RyuhungLiu/USB-PD-48V-ORing/MainCtrl/docs/ui_palette.png

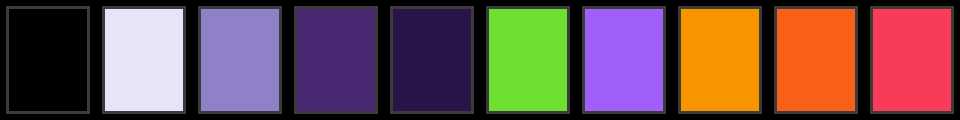
MainCtrl/docs/ui_palette.png
