RyuhungLiu/USB-PD-48V-ORing/MainCtrl/docs/ui_tint_levels.png

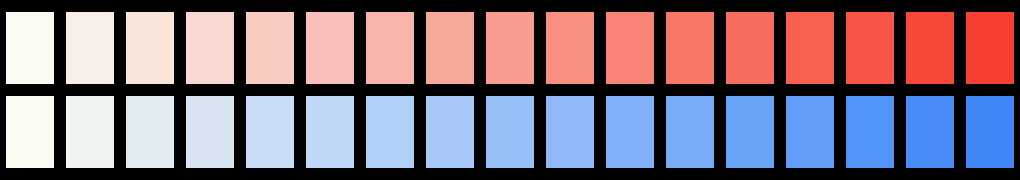
MainCtrl/docs/ui_tint_levels.png
