RyuhungLiu/USB-PD-48V-ORing/MainCtrl/docs/flash_report.html

48V10+10A ORing · Firmware Flash usage · 2026-10-21

# MainCtrl / X035Pd Flash Breakdown

Byte-by-byte attribution of the program Flash of both MCUs: every byte is counted exactly once, and each table sums to the size of the flashed .bin file. V203 is the v0.0.74 RELEASE build (after adding the compact printf and font compression, not yet flashed); X035 is v2.1.0, which is currently running on both units.

V203 main controller52,784 B

92.0% of the 57,344 B program area, 4,560 B left

X035 PD trigger11,676 B

18.7% of the 62,464 B program area, 50,788 B left

V203 top three67% code Fonts 9,169 B (17.4%), strings 3,920 B (7.4%)

Main controller MainCtrl

## CH32V203C8T6

Firmware v0.0.74 (RELEASE build, not yet flashed)

Used

52,784 B

92.0% of program area

Free

4,560 B

4.5 KB

Program area

57,344 B

Chip 64 KB − settings area 8 KB

RAM

18,040 B

88.1% (incl. 2KB stack)

The address map is drawn to scale: colored = used bytes (colors match the categories in the tables below), light = free, hatched = settings area (0x0800E000–0x0800FFFF, two 4KB sectors). Hover over a block to see its address range.

### By category

Category | Bytes | % of used
CodeInstructions compiled from the project source (including parts LTO inlined into other functions, attributed by source file) | 35,220 | 66.7%
WCH SDKPeripheral drivers and system initialization (GPIO, I2C, RCC, DMA, Flash…) | 2,558 | 4.8%
Font bitmapsCompressed bitmaps, offset tables and descriptor structs of the four fonts | 9,169 | 17.4%
String constantsScreen text and format strings (including the terminating 0) | 3,920 | 7.4%
Constant tablesLookup arrays, switch tables (CSWTCH), literal pools and other anonymous constants | 738 | 1.4%
.data initial valuesInitialized RAM variables, copied from Flash at boot | 218 | 0.4%
C librarynewlib-nano and libgcc (mem*/str*, save-restore, 64-bit division) | 260 | 0.5%
Vector table.init jump + interrupt vector table | 256 | 0.5%
Alignment paddingZero padding between functions and constants (including a few anonymous constants whose value is 0) | 445 | 0.8%
Total | 52,784 | 100%

### By module

Module | Bytes | % of used
ui/pages screen pages | 14,883 | 28.2%
ui/fonts font bitmaps | 9,169 | 17.4%
power current sharing, protection, measurement | 7,905 | 15.0%
String constants (not per file) | 3,920 | 7.4%
ui drawing core | 3,434 | 6.5%
app settings, statistics, trends | 2,624 | 5.0%
WCH SDK | 2,598 | 4.9%
drivers peripheral drivers | 2,470 | 4.7%
pd X035 communication | 2,218 | 4.2%
bsp clock, Flash, printf | 2,010 | 3.8%
Alignment padding | 445 | 0.8%
C library | 260 | 0.5%
Vector table | 256 | 0.5%
main.c | 246 | 0.5%
Other | 196 | 0.4%
Anonymous constants (not per file) | 150 | 0.3%
Total | 52,784 | 100%

### Largest functions

Function size is the actual machine-code bytes. LTO inlines small functions into their callers, so main is large; the right column shows which source files these bytes come from (top 4).

Symbol | Bytes | Source (bytes)
main | 9,272 | share.c 2990, oring.c 1400, pd_node.c 1328, ui.c 502 …+19
update.lto_priv.2 | 3,430 | page_home.c 2942, gfx.c 412, share.c 52, meter.c 24
update.lto_priv.1 | 1,126 | page_caps.c 1088, gfx.c 38
update.lto_priv.5 | 1,090 | page_setup.c 942, settings.c 72, sys.c 48, resetlog.c 28
update.lto_priv.6 | 1,022 | page_stats.c 996, stats.c 26
update.lto_priv.8 | 1,014 | page_volt.c 910, pd_node.c 50, app.c 30, pd_decode.c 24
vsnprintf | 896 | tiny_printf.c 896
update.lto_priv.4 | 890 | page_mos.c 874, oring.c 16
update.lto_priv.0 | 794 | page_bal.c 768, share.c 26
on_key.lto_priv.8 | 736 | page_volt.c 710, settings.c 20, ui.c 6
save.isra.0 | 696 | settings.c 314, ch32v20x_flash.c 180, flash.c 166, stats.c 36
gfx_draw_char | 654 | gfx.c 498, st7789.c 70, fonts.c 68, ch32v20x_gpio.c 18
update.lto_priv.7 | 540 | page_trend.c 464, trend.c 36, st7789.c 28, ch32v20x_gpio.c 12
handle_caps | 464 | pd_decode.c 322, pd_node.c 142
check_enter | 454 | share.c 436, app.c 18
draw.lto_priv.2 | 446 | page_home.c 446
bus_recover | 436 | ch32v20x_i2c.c 266, i2c_bus.c 80, ch32v20x_gpio.c 64, ch32v20x_rcc.c 26
link_init | 434 | ch32v20x_dma.c 192, ch32v20x_usart.c 130, uart_link.c 112
draw_static | 406 | page_home.c 358, gfx.c 48
ina2xx_init.constprop.0.isra.0 | 406 | ina2xx.c 406

### Largest constants and initial values

There are 291 string constants totaling 3,920 B. The compiler does not give strings symbol names, so they are counted separately under "String constants".

Symbol | Bytes | Kind | Source
font_num_out_bitmap | 2,458 | Constant | font_num_out.c
font_16x24_bitmap | 2,395 | Constant | font_16x24.c
font_8x16_bitmap | 2,047 | Constant | font_8x16.c
font_num_ch_bitmap | 1,867 | Constant | font_num_ch.c
font_8x16_offset | 162 | Constant | font_8x16.c
prot_log | 136 | RAM initial value | oring.c
font_16x24_offset | 78 | Constant | font_16x24.c
trip_names | 52 | Constant | stats.c
CSWTCH.7 | 40 | Constant | (unknown)
hw.lto_priv.0 | 32 | Constant | uart_link.c
CSWTCH.61 | 28 | Constant | (unknown)
font_8x16 | 24 | Constant | font_8x16.c
font_16x24 | 24 | Constant | font_16x24.c
font_num_ch | 24 | Constant | font_num_ch.c
font_num_out | 24 | Constant | font_num_out.c
CSWTCH.10 | 24 | Constant | (unknown)

All source files (57, code + constants + initial values)

File | Bytes | % of used
src/power/share.c | 4,774 | 9.0%
src/ui/pages/page_home.c | 4,091 | 7.8%
src/ui/fonts/font_num_out.c | 2,515 | 4.8%
src/ui/fonts/font_16x24.c | 2,497 | 4.7%
src/power/oring.c | 2,473 | 4.7%
src/ui/fonts/font_8x16.c | 2,233 | 4.2%
src/ui/pages/page_volt.c | 2,002 | 3.8%
src/ui/fonts/font_num_ch.c | 1,924 | 3.6%
src/pd/pd_node.c | 1,872 | 3.5%
src/ui/gfx.c | 1,728 | 3.3%
src/ui/pages/page_setup.c | 1,534 | 2.9%
src/ui/pages/page_mos.c | 1,412 | 2.7%
src/ui/pages/page_stats.c | 1,368 | 2.6%
src/ui/pages/page_bal.c | 1,350 | 2.6%
src/ui/pages/page_caps.c | 1,224 | 2.3%
src/ui/pages/page_trend.c | 1,128 | 2.1%
src/ui/ui.c | 1,098 | 2.1%
src/app/settings.c | 1,020 | 1.9%
src/bsp/tiny_printf.c | 950 | 1.8%
src/drivers/ina2xx.c | 816 | 1.5%
src/ui/pages/page_menu.c | 774 | 1.5%
src/app/stats.c | 672 | 1.3%
src/drivers/st7789.c | 658 | 1.2%
src/power/meter.c | 658 | 1.2%
SDK/Peripheral/ch32v20x/src/ch32v20x_gpio.c | 530 | 1.0%
SDK/Peripheral/ch32v20x/src/ch32v20x_i2c.c | 524 | 1.0%
src/app/app.c | 500 | 0.9%
src/app/trend.c | 432 | 0.8%
src/bsp/delay.c | 380 | 0.7%
src/drivers/i2c_bus.c | 368 | 0.7%
SDK/Peripheral/ch32v20x/src/ch32v20x_rcc.c | 352 | 0.7%
src/pd/pd_decode.c | 346 | 0.7%
src/drivers/key.c | 330 | 0.6%
src/bsp/sys.c | 330 | 0.6%
SDK/Peripheral/ch32v20x/src/ch32v20x_dma.c | 324 | 0.6%
SDK/System/ch32v20x/system_ch32v20x.c | 314 | 0.6%
src/drivers/uart_link.c | 298 | 0.6%
src/ui/widget.c | 264 | 0.5%
src/main.c | 246 | 0.5%
SDK/Peripheral/ch32v20x/src/ch32v20x_flash.c | 234 | 0.4%
(unknown) | 196 | 0.4%
src/bsp/resetlog.c | 184 | 0.3%
src/ui/fmt.c | 180 | 0.3%
src/bsp/flash.c | 166 | 0.3%
src/ui/fonts/fonts.c | 164 | 0.3%
SDK/Peripheral/ch32v20x/src/ch32v20x_usart.c | 140 | 0.3%
SDK/Peripheral/ch32v20x/src/ch32v20x_spi.c | 104 | 0.2%
libgcc.a:save-restore.o | 96 | 0.2%
SDK/Peripheral/ch32v20x/src/ch32v20x_iwdg.c | 70 | 0.1%
libgcc.a:_lshrdi3.o | 38 | 0.1%
libc_nano.a:lib_a-memcmp.o | 36 | 0.1%
libc_nano.a:lib_a-memcpy-asm.o | 22 | 0.0%
libc_nano.a:lib_a-strcmp.o | 20 | 0.0%
libc_nano.a:lib_a-memset.o | 16 | 0.0%
libc_nano.a:lib_a-strcpy.o | 16 | 0.0%
libc_nano.a:lib_a-strlen.o | 16 | 0.0%
SDK/Peripheral/ch32v20x/src/ch32v20x_misc.c | 6 | 0.0%

PD trigger X035Pd ×2

## CH32X035F8U6

Firmware v2.1.0 (byte-for-byte identical to output/X035Pd_v2.1.0.bin)

Used

11,676 B

18.7% of program area

Free

50,788 B

49.6 KB

Program area

62,464 B

Chip 62 KB − NV page 1 KB

RAM

2,960 B

14.5% (incl. 2KB stack)

The address map is drawn to scale: colored = used bytes (colors match the categories in the tables below), light = free, hatched = NV page (0x0800F400–0x0800F7FF). Hover over a block to see its address range.

### By category

Category | Bytes | % of used
CodeInstructions compiled from the project source (including parts LTO inlined into other functions, attributed by source file) | 8,456 | 72.4%
WCH SDKPeripheral drivers and system initialization (GPIO, I2C, RCC, DMA, Flash…) | 1,316 | 11.3%
String constantsScreen text and format strings (including the terminating 0) | 25 | 0.2%
Constant tablesLookup arrays, switch tables (CSWTCH), literal pools and other anonymous constants | 171 | 1.5%
.data initial valuesInitialized RAM variables, copied from Flash at boot | 39 | 0.3%
C librarynewlib-nano and libgcc (mem*/str*, save-restore, 64-bit division) | 1,360 | 11.6%
Vector table.init jump + interrupt vector table | 256 | 2.2%
Alignment paddingZero padding between functions and constants (including a few anonymous constants whose value is 0) | 53 | 0.5%
Total | 11,676 | 100%

### By module

Module | Bytes | % of used
usbpd_pe policy engine | 3,096 | 26.5%
C library | 1,360 | 11.6%
WCH SDK | 1,352 | 11.6%
usbpd_phy physical layer | 1,263 | 10.8%
usbpd_pdo PDO parsing/selection | 1,224 | 10.5%
link UART protocol | 1,098 | 9.4%
usbpd_prl protocol layer | 968 | 8.3%
usbpd_tc Type-C | 276 | 2.4%
Vector table | 256 | 2.2%
nv parameter page | 204 | 1.7%
Anonymous constants (not per file) | 159 | 1.4%
vbus voltage measurement | 148 | 1.3%
sys_time time base | 144 | 1.2%
Alignment padding | 53 | 0.5%
main.c | 50 | 0.4%
String constants (not per file) | 25 | 0.2%
Total | 11,676 | 100%

### Largest functions

Function size is the actual machine-code bytes. LTO inlines small functions into their callers, so main is large; the right column shows which source files these bytes come from (top 4).

Symbol | Bytes | Source (bytes)
main | 3,326 | usbpd_prl.c 605, usbpd_pe.c 526, link.c 438, ch32x035_flash.c 264 …+15
run_state | 2,108 | usbpd_pe.c 2048, usbpd_phy.c 20, core_riscv.h 20, vbus.c 10 …+2
__udivdi3 | 934 | libgcc.a:_udivdi3.o 934
USBPD_IRQHandler | 410 | usbpd_phy.c 410
pd_pdo_decode | 378 | usbpd_pdo.c 378
tx | 314 | usbpd_phy.c 186, usbpd_prl.c 64, sys_time.c 30, core_riscv.h 20 …+1
pd_select.constprop.0 | 238 | usbpd_pdo.c 238
vbus_sample | 230 | vbus.c 120, ch32x035_adc.c 110
build | 208 | usbpd_pdo.c 208
phy_rp_level | 206 | usbpd_phy.c 176, core_riscv.h 30
send_status | 176 | link.c 162, usbpd_tc.c 14
pd_select_nearest.constprop.0 | 170 | usbpd_pdo.c 170
take_caps | 168 | usbpd_pe.c 156, usbpd_prl.c 12
link_send | 130 | link.c 130
pd_pdo_max_ma_at | 120 | usbpd_pdo.c 120
tx_raw | 110 | usbpd_phy.c 110
store_caps | 108 | usbpd_pe.c 108
phy_cc_detect | 104 | usbpd_phy.c 104
send_caps | 98 | link.c 98
find.constprop.0 | 98 | usbpd_pdo.c 98

### Largest constants and initial values

There are 11 string constants totaling 25 B. The compiler does not give strings symbol names, so they are counted separately under "String constants".

Symbol | Bytes | Kind | Source
__clz_tab | 256 | Constant | libgcc.a:_clz.o
AHBPrescTable | 16 | RAM initial value | system_ch32x035.c
APBAHBPrescTable | 16 | RAM initial value | ch32x035_rcc.c
adj_order.0 | 12 | Constant | usbpd_pdo.c

All source files (26, code + constants + initial values)

File | Bytes | % of used
src/usbpd_pe.c | 3,096 | 26.5%
src/usbpd_phy.c | 1,263 | 10.8%
src/usbpd_pdo.c | 1,224 | 10.5%
src/link.c | 1,098 | 9.4%
src/usbpd_prl.c | 968 | 8.3%
libgcc.a:_udivdi3.o | 934 | 8.0%
src/usbpd_tc.c | 276 | 2.4%
SDK/Peripheral/ch32x035/src/ch32x035_flash.c | 264 | 2.3%
libgcc.a:_clz.o | 256 | 2.2%
SDK/Peripheral/ch32x035/src/ch32x035_gpio.c | 240 | 2.1%
src/nv.c | 204 | 1.7%
SDK/Peripheral/ch32x035/src/ch32x035_adc.c | 184 | 1.6%
SDK/Peripheral/ch32x035/src/ch32x035_usart.c | 150 | 1.3%
src/vbus.c | 148 | 1.3%
src/sys_time.c | 144 | 1.2%
SDK/Peripheral/ch32x035/src/ch32x035_rcc.c | 126 | 1.1%
SDK/Core/ch32x035/core_riscv.h | 122 | 1.0%
SDK/System/ch32x035/system_ch32x035.c | 106 | 0.9%
libgcc.a:save-restore.o | 96 | 0.8%
SDK/Peripheral/ch32x035/src/ch32x035_dma.c | 94 | 0.8%
SDK/Peripheral/ch32x035/src/ch32x035_iwdg.c | 60 | 0.5%
src/main.c | 50 | 0.4%
libc_nano.a:lib_a-memcmp.o | 36 | 0.3%
libc_nano.a:lib_a-memcpy-asm.o | 22 | 0.2%
libc_nano.a:lib_a-memset.o | 16 | 0.1%
SDK/Peripheral/ch32x035/src/ch32x035_misc.c | 6 | 0.1%

## Further possible savings

1. X035 64-bit division 1,190 B (10.2% of X035 used): sys_time_ms() and sys_time_us() divide the 64-bit SysTick by 48000/48, which links in libgcc's __udivdi3 (934 B) and its lookup table __clz_tab (256 B). Shifting right first and then doing a 32-bit division, or using multiply-and-shift, would remove all of it. The X035 still has plenty of space, so this is not urgent.
2. V203 string constants 3,920 B: mainly on-screen hint sentences, menu descriptions and non-LOG format strings (the longest about 40 characters). Shortening the twenty or thirty longest could save a few hundred bytes, at the cost of less descriptive text.
3. V203 prot_log has 136 B of initial values in .data: only so that it carries the magic "PEVT" from boot. Moving it to .bss and writing the magic during initialization would save about 128 B of Flash.
4. switch lookup tables (CSWTCH) 196 B: the compiler turns string switches into lookup tables; this is a normal optimization and handling it manually is not recommended.
5. main 9,272 B needs no action: this is the result of LTO inlining each module's *_init/*_process into it; the source-file attribution has already been split back to the individual files in the "By module" table.

## Method

- Sizes come from the ELF of the actual build: the load image of .init + .vector + .text + .data, which equals the .bin size (V203 52,784 B, X035 11,676 B).
- Source-file attribution comes from a build of the same program with -g2 added, reading only the DWARF line table and variable information. The V203 -g2 build is byte-for-byte identical to the release .bin; on the X035 two functions (main, USBPD_IRQHandler) each differ by 4 B, so X035 function sizes are always taken from the release build and then distributed to source files in proportion to the line numbers of the -g2 build.
- Inlined code is attributed to its original source file via the line table; newlib/libgcc functions without debug information are attributed via the link map to the .a member they belong to.
- Bytes without a symbol: null-terminated printable ASCII sequences are counted as string constants; of the rest, zero bytes are counted as alignment padding and non-zero bytes as anonymous constants (literal pools, jump tables, etc.).
- The V203 program area of 57,344 B is limited by board_upload.maximum_size, with the last 8KB being the settings area; the X035 linker script sets Flash to 61KB, with the last 1KB being the NV page.
