RyuhungLiu/USB-PD-48V-ORing/ATX_PSU/mechanical/out/fan_down/gui_bottom.png

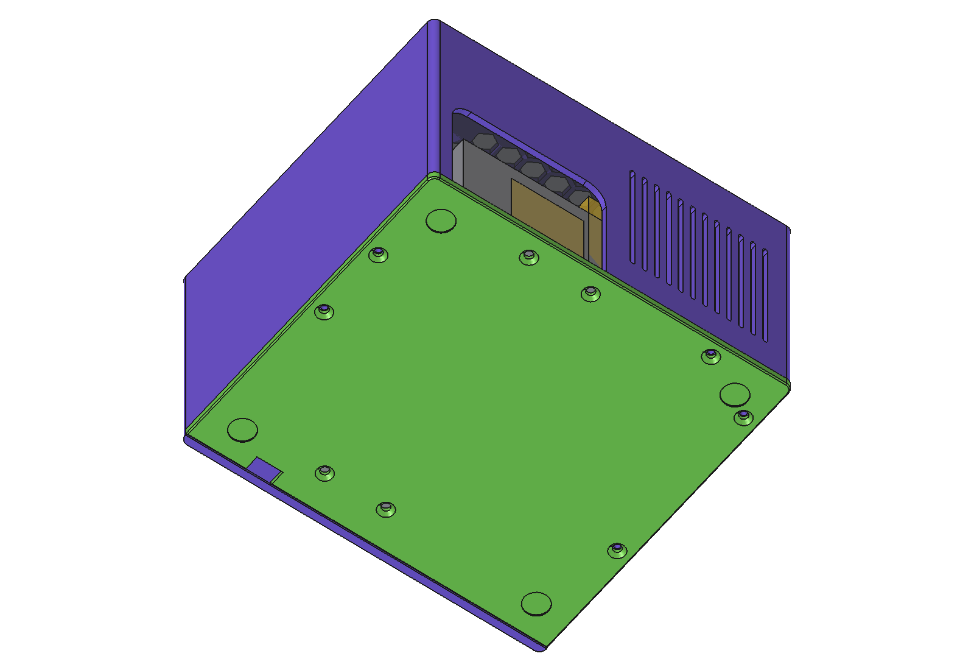
ATX_PSU/mechanical/out/fan_down/gui_bottom.png
