RyuhungLiu/USB-PD-48V-ORing/ATX_PSU/mechanical/out/fan_down/gui_inside_noshell.png

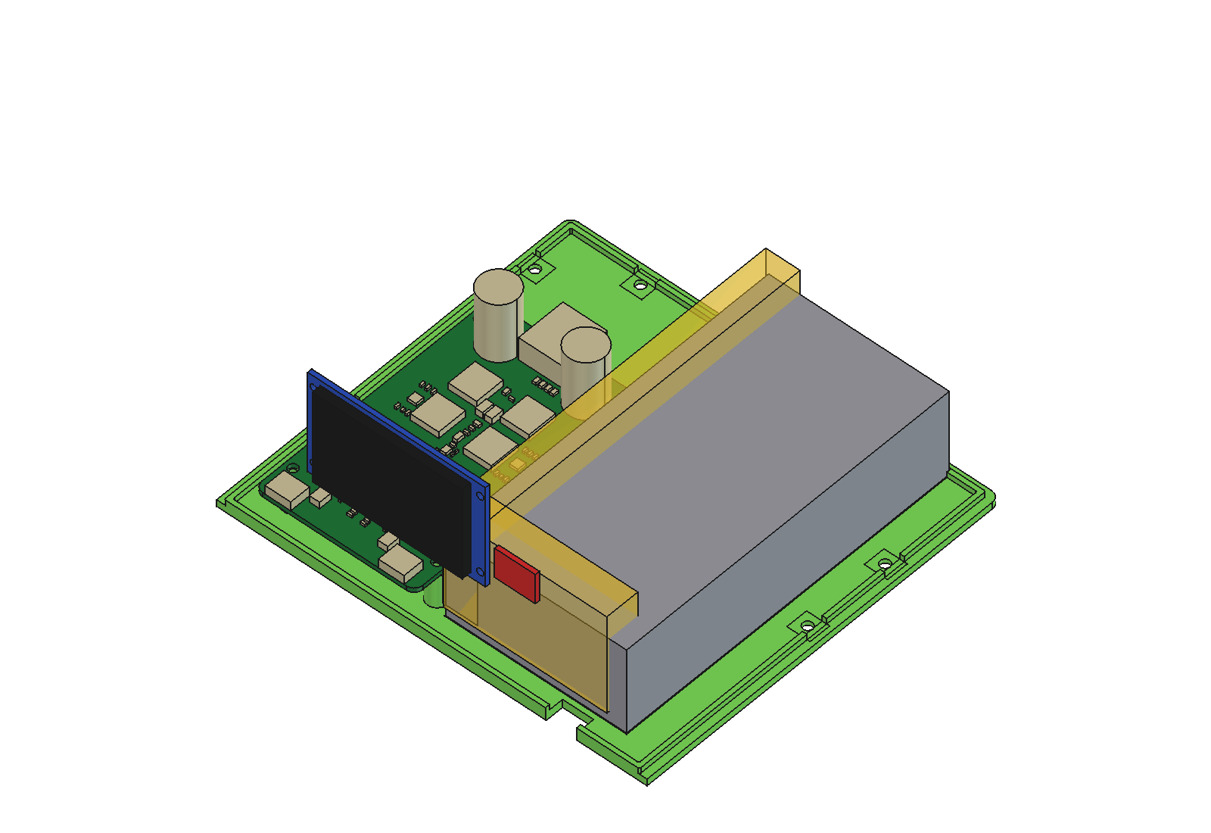
ATX_PSU/mechanical/out/fan_down/gui_inside_noshell.png
