RyuhungLiu/USB-PD-48V-ORing/Enclosure/out/gui_back.png

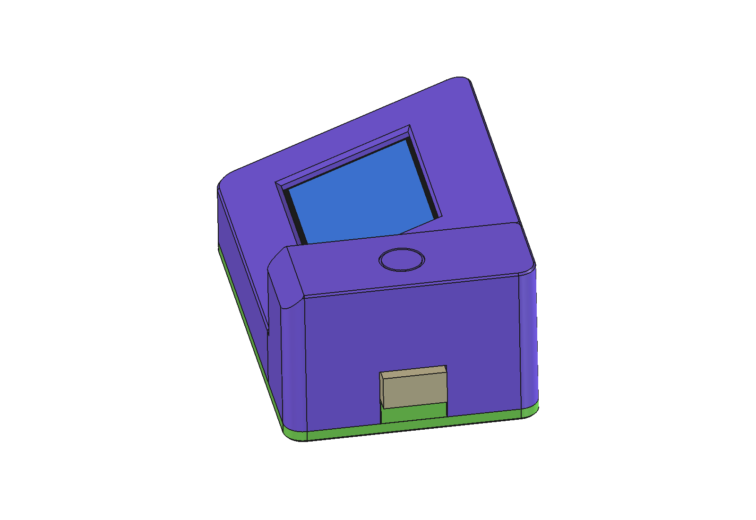
Enclosure/out/gui_back.png
