RyuhungLiu/USB-PD-48V-ORing/Enclosure/out/gui_bottom.png

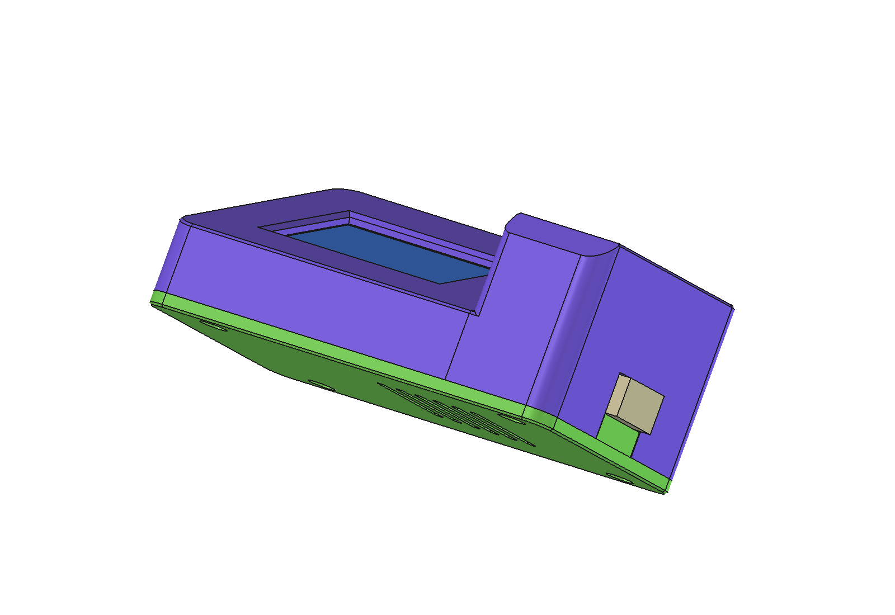
Enclosure/out/gui_bottom.png
