RyuhungLiu/USB-PD-48V-ORing/Enclosure/out/gui_front_left.png

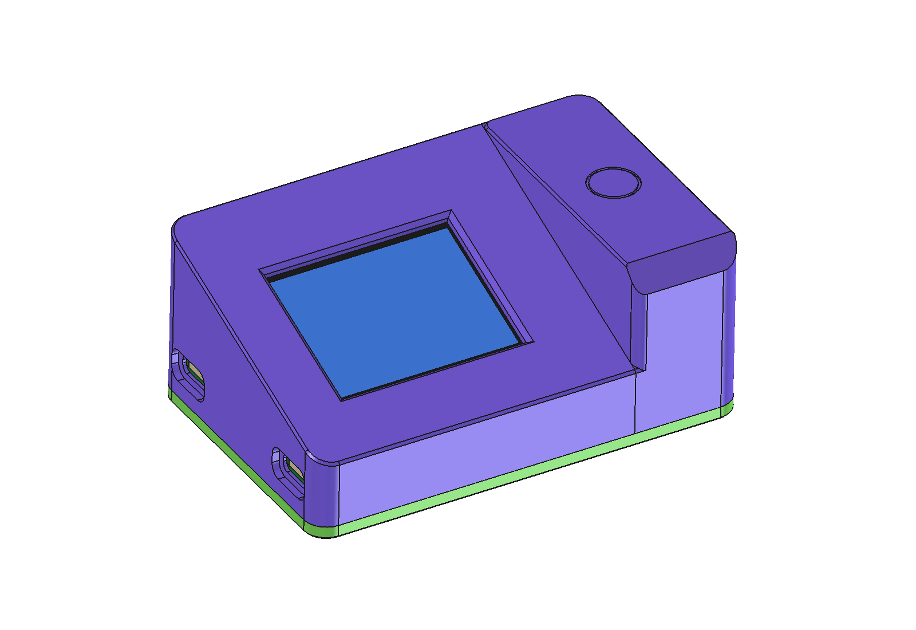
Enclosure/out/gui_front_left.png
