RyuhungLiu/USB-PD-48V-ORing/Enclosure/out/gui_front_right.png

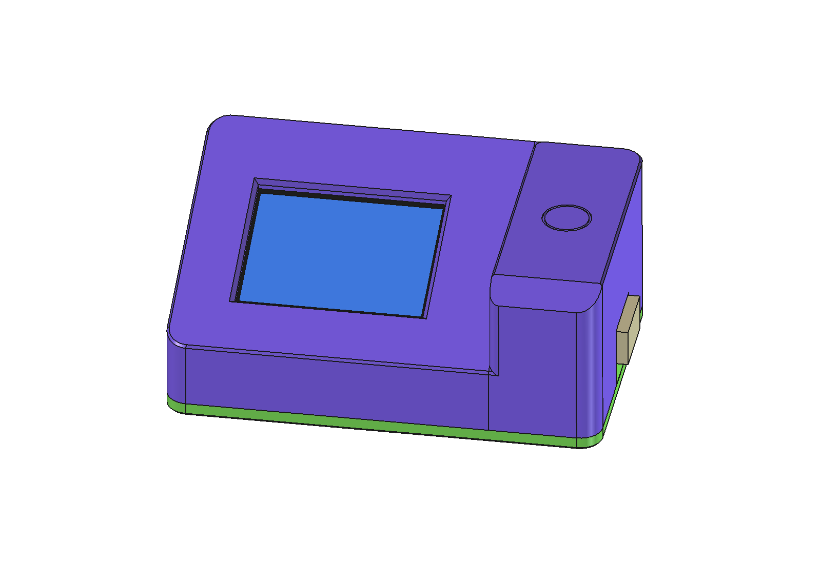
Enclosure/out/gui_front_right.png
