RyuhungLiu/USB-PD-48V-ORing/Enclosure/out/gui_inside.png

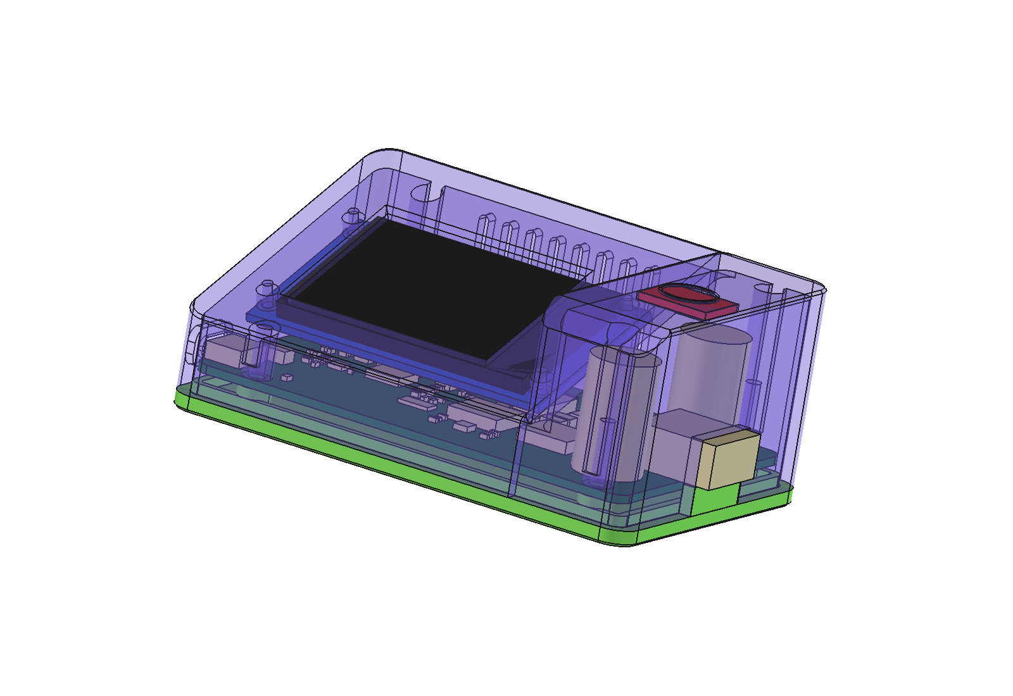
Enclosure/out/gui_inside.png
