RyuhungLiu/USB-PD-48V-ORing/Enclosure/out/gui_inside_nocover.png

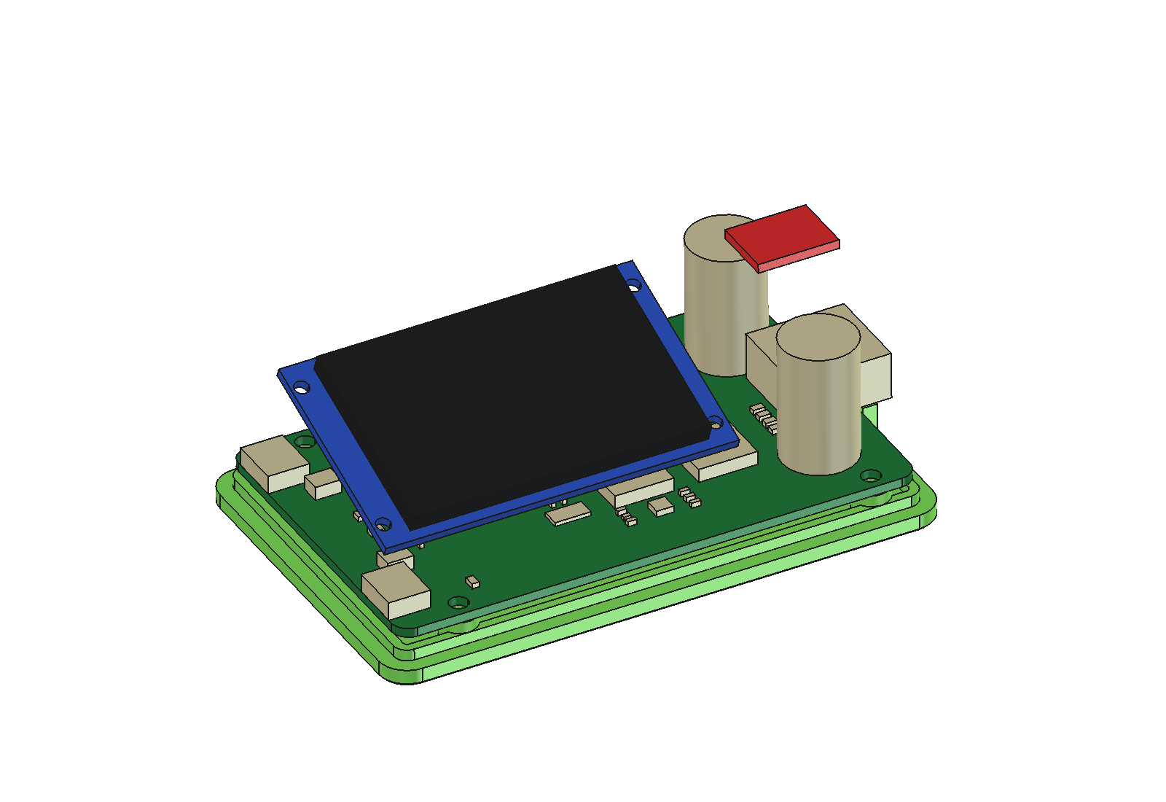
Enclosure/out/gui_inside_nocover.png
