RyuhungLiu/USB-PD-48V-ORing/Enclosure/out/preview_section.png

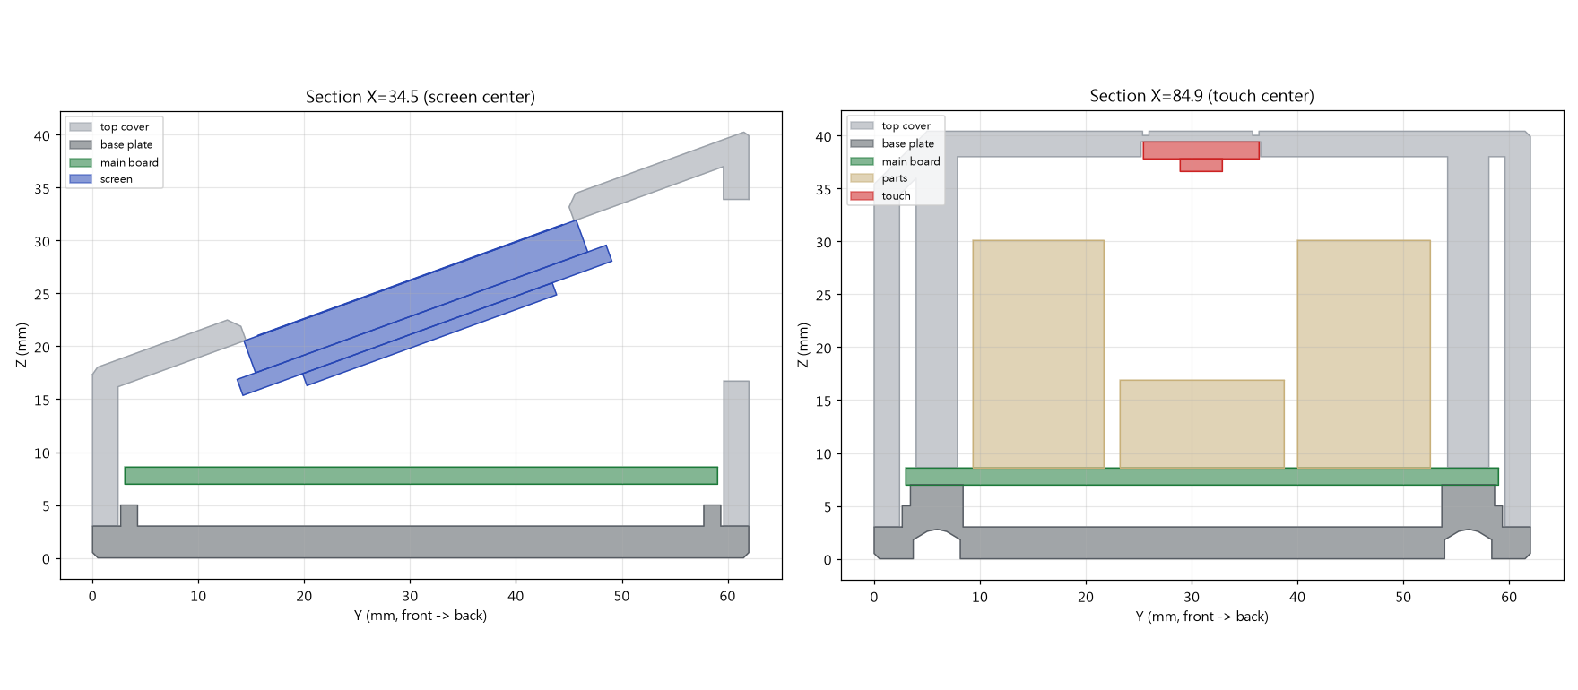
Enclosure/out/preview_section.png
