RyuhungLiu/USB-PD-48V-ORing/Enclosure/out/preview_top.png

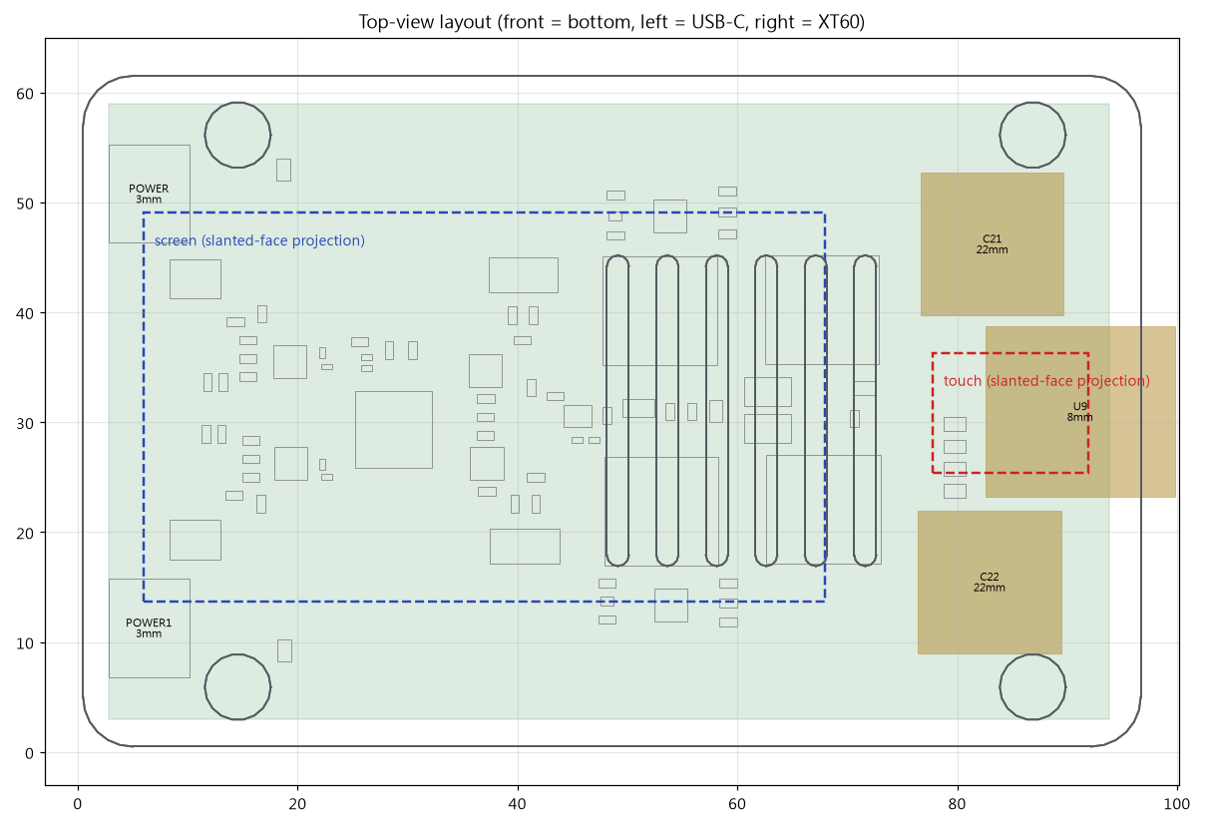
Enclosure/out/preview_top.png
