RyuhungLiu/USB-PD-48V-ORing/MainCtrl/docs/ui_caps.png

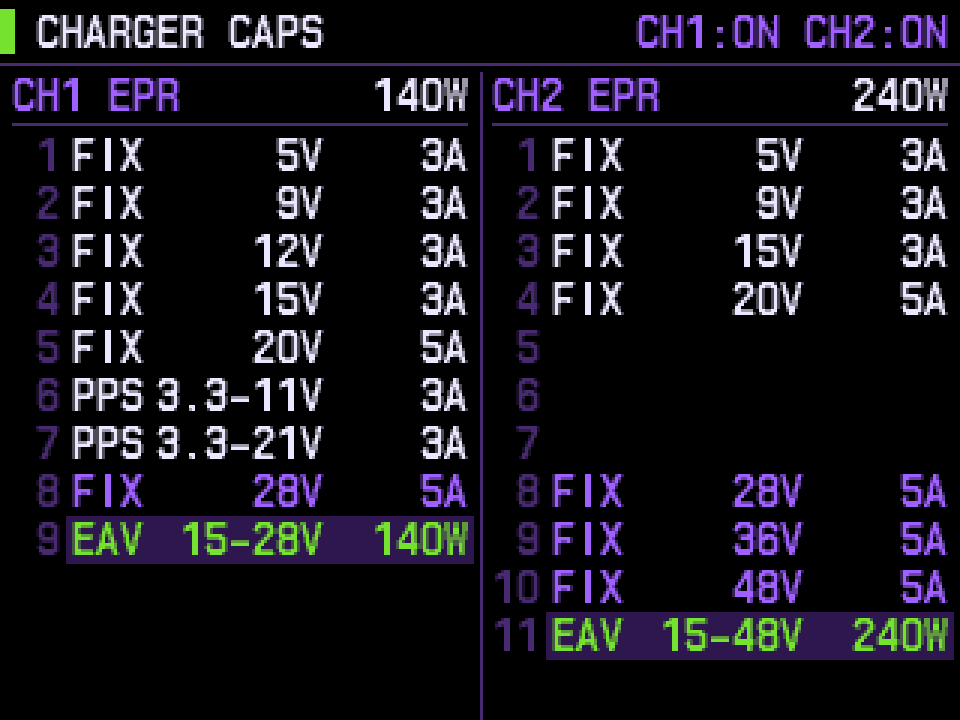
MainCtrl/docs/ui_caps.png
