RyuhungLiu/USB-PD-48V-ORing/MainCtrl/docs/ui_home_balance.png

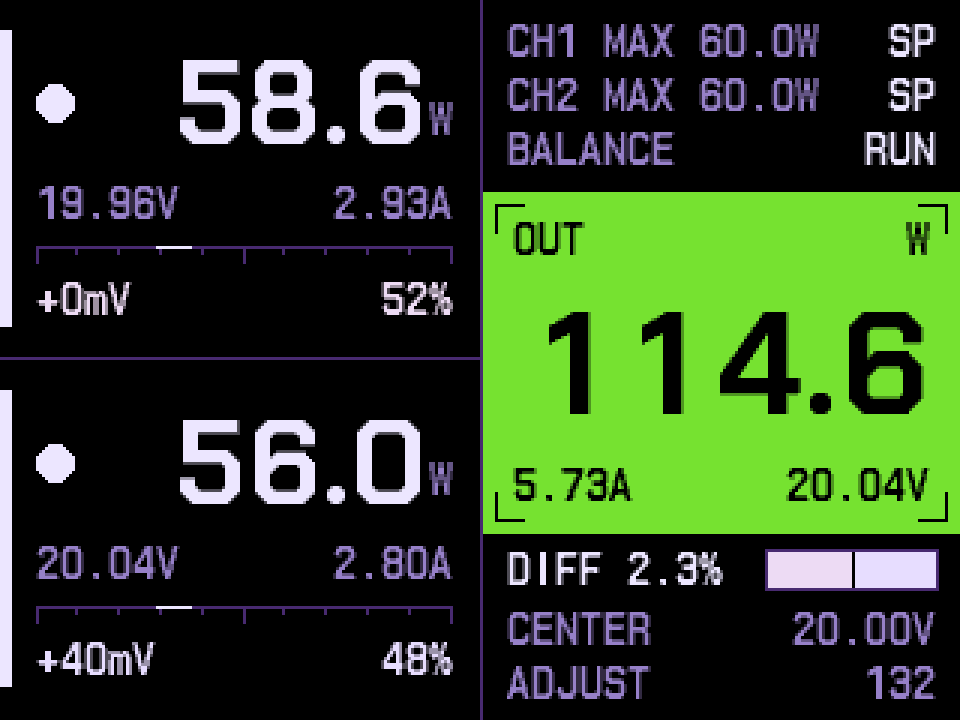
MainCtrl/docs/ui_home_balance.png
