RyuhungLiu/USB-PD-48V-ORing/MainCtrl/docs/ui_home_off.png

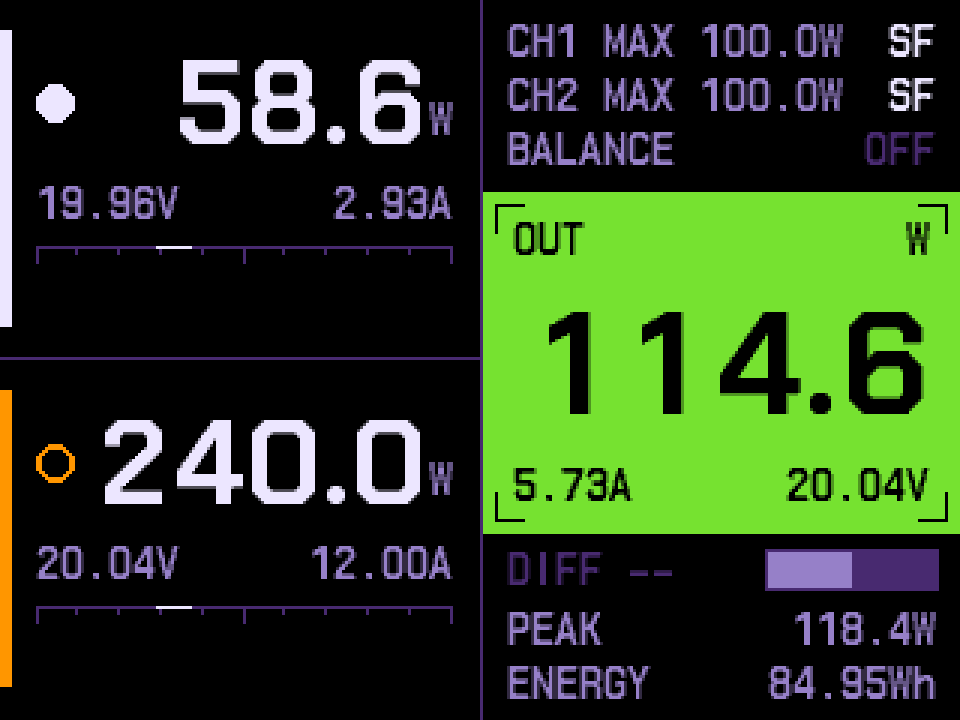
MainCtrl/docs/ui_home_off.png
