RyuhungLiu/USB-PD-48V-ORing/MainCtrl/docs/ui_trend.png

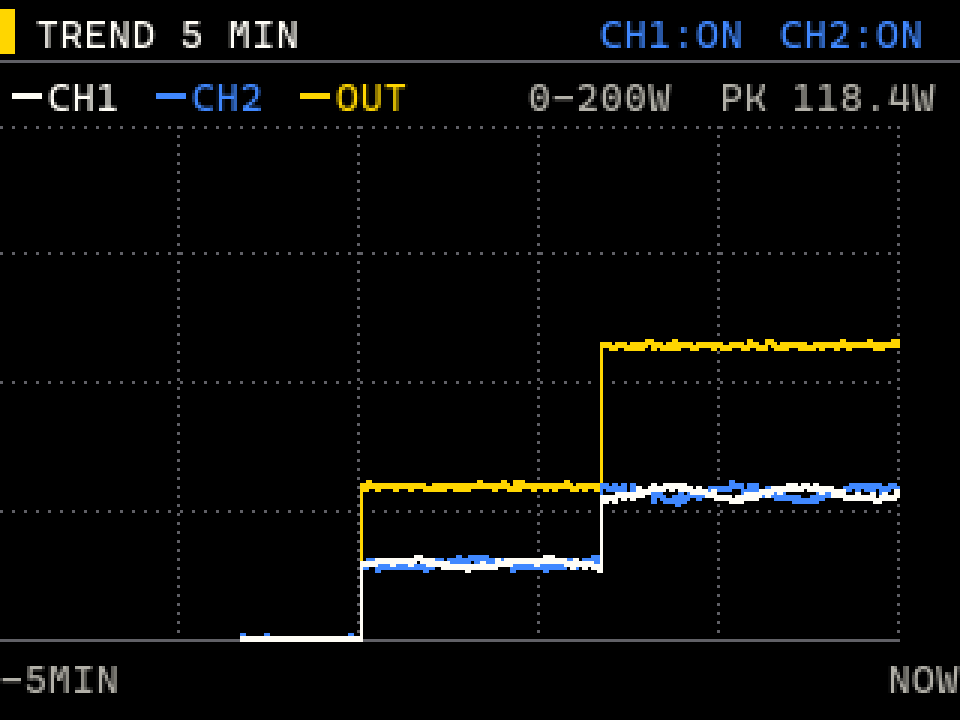
MainCtrl/docs/ui_trend.png
