RyuhungLiu/USB-PD-48V-ORing/MainCtrl/tools/font_preview.png

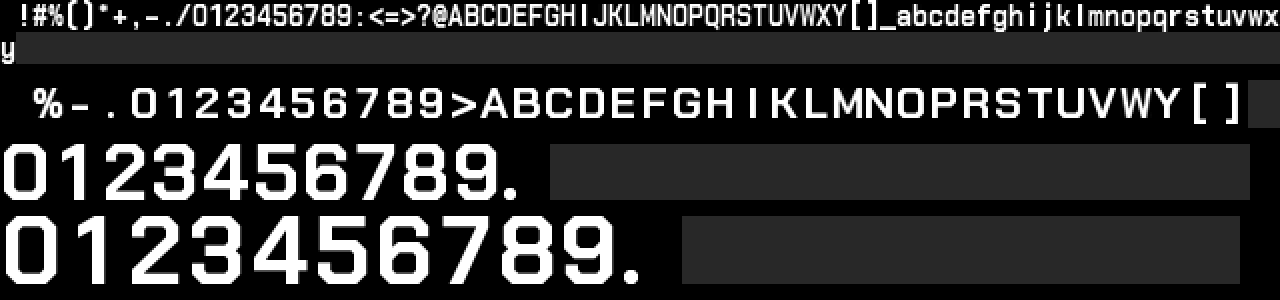
MainCtrl/tools/font_preview.png
