RyuhungLiu/USB-PD-48V-ORing/Enclosure/out/assembly.step

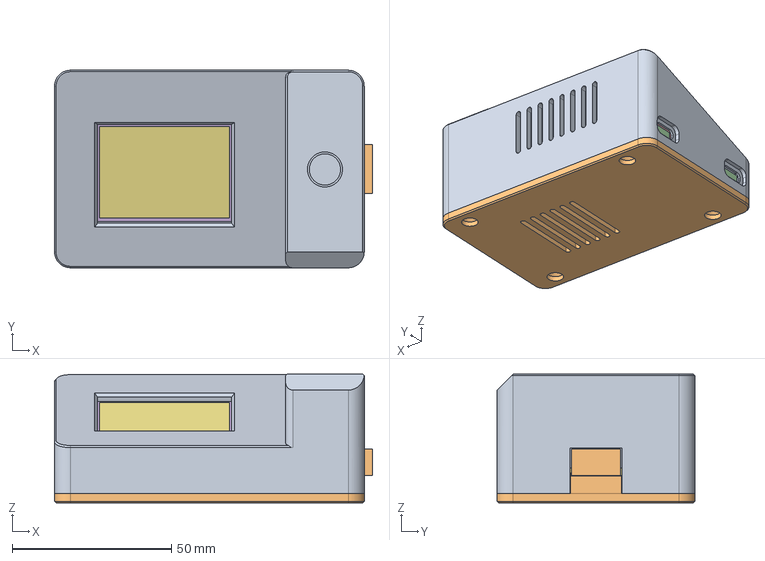
[picture p21: CAD file, 2026-10-29]
Enclosure/out/assembly.step
99.8 x 62.0 x 40.4 mm
