RyuhungLiu/USB-PD-48V-ORing/ATX_PSU/mechanical/out/fan_up/assembly.step

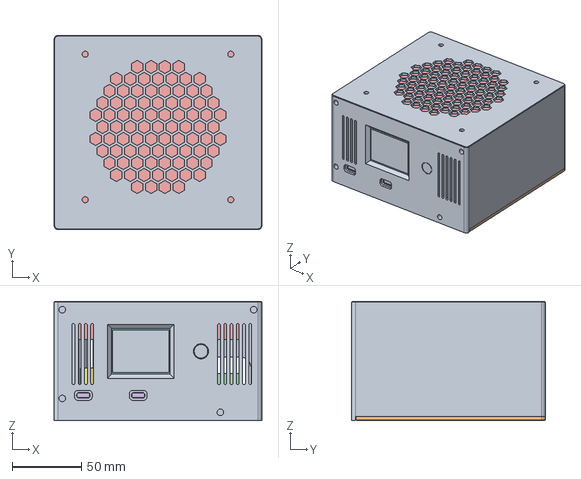
[picture p22: CAD file, 2026-10-29]
ATX_PSU/mechanical/out/fan_up/assembly.step
150.0 x 140.0 x 86.0 mm
