RyuhungLiu/USB-PD-48V-ORing/ATX_PSU/mechanical/ORing_ATX_PSU_fan_down.FCStd

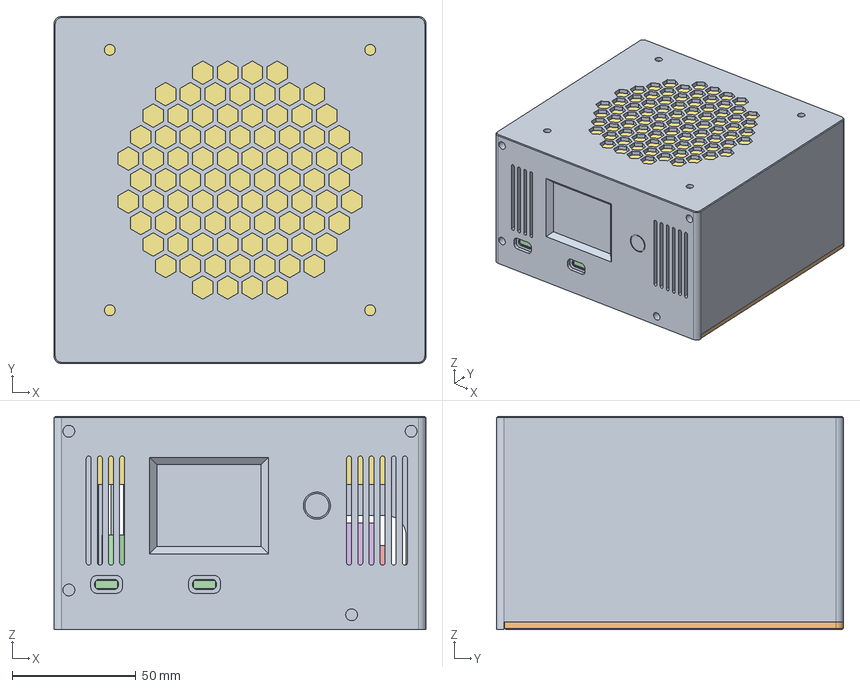
[picture p23: CAD file, 2026-10-29]
ATX_PSU/mechanical/ORing_ATX_PSU_fan_down.FCStd
150.0 x 140.0 x 86.0 mm
Base
ORing_PCB
ORing_Parts
X9_ATX_500
X9_Connectors
Fan_120
LCD_PCB
LCD_Glass
LCD_BackParts
TTP223
