RyuhungLiu/USB-PD-48V-ORing/ATX_PSU/mechanical/out/fan_down/base.step

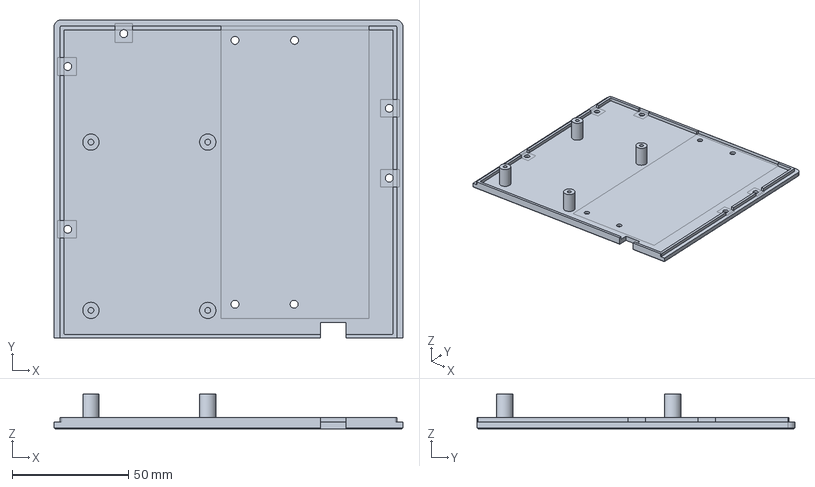
[picture p24: CAD file, 2026-10-29]
ATX_PSU/mechanical/out/fan_down/base.step
150.0 x 136.8 x 15.0 mm
