RyuhungLiu/USB-PD-48V-ORing/ATX_PSU/mechanical/out/fan_down/print/1_shell.stl

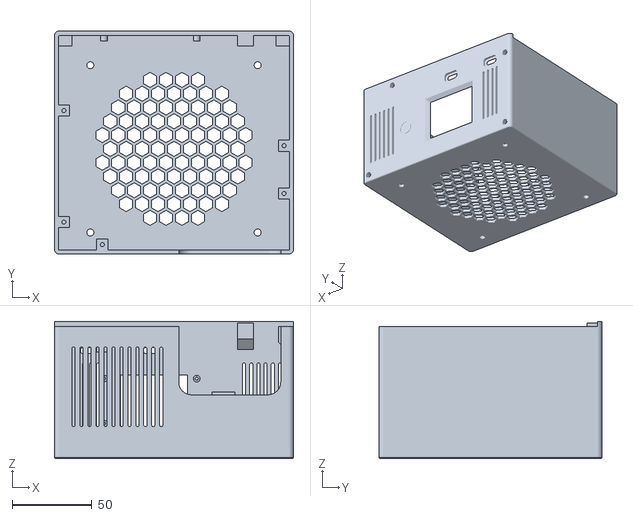
[picture p25: CAD file, 2026-10-29]
ATX_PSU/mechanical/out/fan_down/print/1_shell.stl
150.0 x 140.0 x 86.0
