RyuhungLiu/USB-PD-48V-ORing/Enclosure/ORing_Enclosure.FCStd

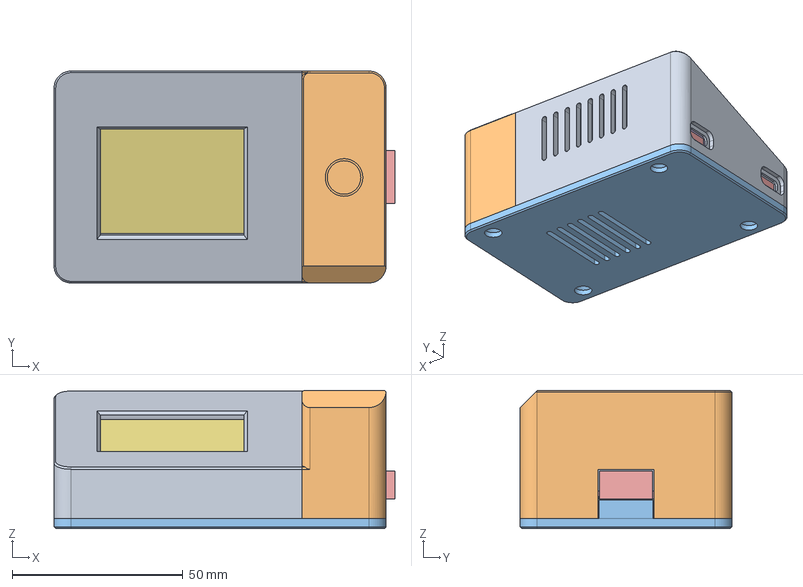
[picture p26: CAD file, 2026-10-29]
Enclosure/ORing_Enclosure.FCStd
99.8 x 62.0 x 40.4 mm
CoverPanel
CoverShelf
Base
PCB
PCB_Parts
LCD_PCB
LCD_Glass
LCD_BackParts
TTP223
