RyuhungLiu/USB-PD-48V-ORing/Enclosure/out/print/2_cover_shelf.stl

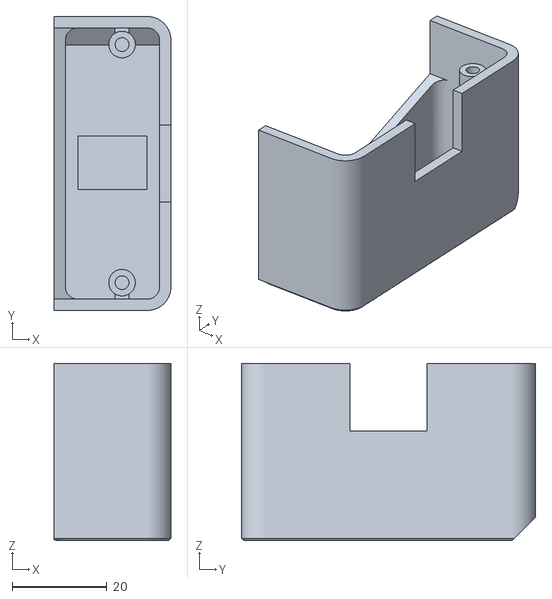
[picture p27: CAD file, 2026-10-29]
Enclosure/out/print/2_cover_shelf.stl
24.7 x 62.0 x 37.4
