RyuhungLiu/USB-PD-48V-ORing/Enclosure/out/base.step

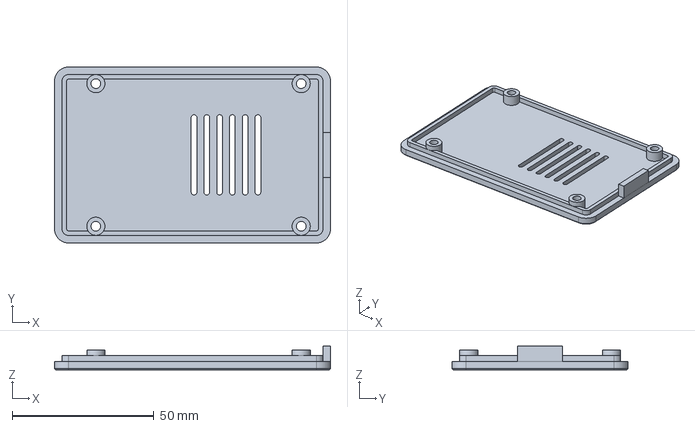
[picture p28: CAD file, 2026-10-29]
Enclosure/out/base.step
97.2 x 62.0 x 8.40 mm
