RyuhungLiu/USB-PD-48V-ORing/Enclosure/out/print/1_cover_panel.stl

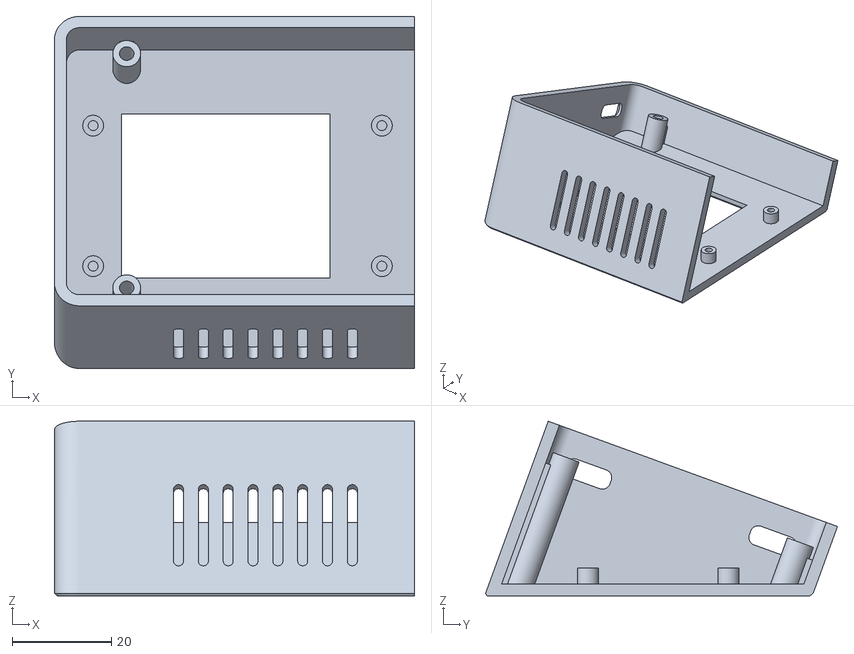
[picture p29: CAD file, 2026-10-29]
Enclosure/out/print/1_cover_panel.stl
72.5 x 70.9 x 35.2
