RyuhungLiu/USB-PD-48V-ORing/Enclosure/out/cover_panel.step

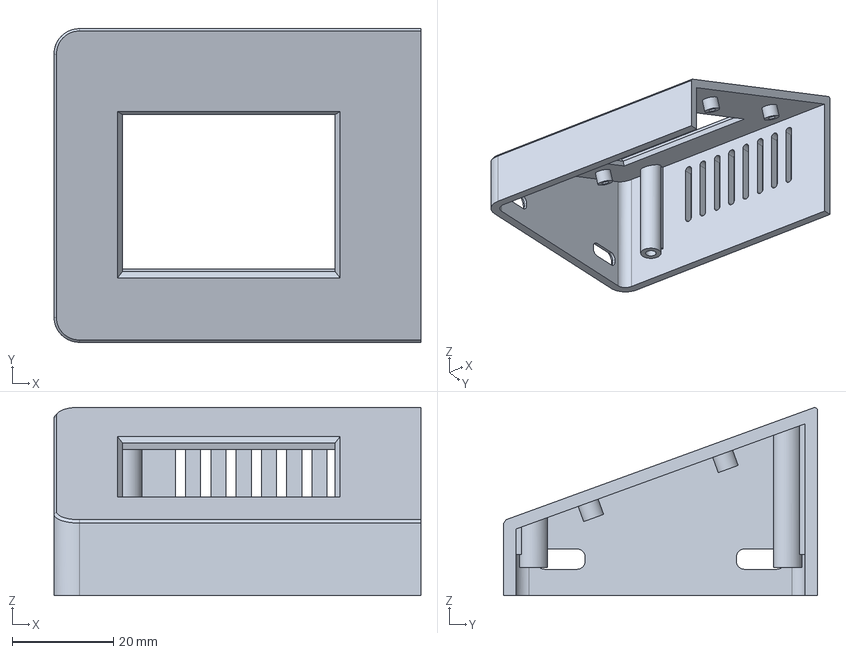
[picture p30: CAD file, 2026-10-29]
Enclosure/out/cover_panel.step
72.5 x 62.0 x 37.2 mm
