RyuhungLiu/USB-PD-48V-ORing/(list of files, cad)

Other CAD files:
ATX_PSU/mechanical/out/fan_down/assembly.step
ATX_PSU/mechanical/out/fan_up/print/2_base.stl
ATX_PSU/mechanical/out/fan_up/shell.step
ATX_PSU/mechanical/ORing_ATX_PSU_fan_up.FCStd
ATX_PSU/mechanical/out/fan_down/shell.step
ATX_PSU/mechanical/out/fan_up/print/1_shell.stl
Enclosure/out/print/3_base.stl
ATX_PSU/mechanical/out/fan_up/base.step
Enclosure/out/cover_shelf.step
