RyuhungLiu/USB-PD-48V-ORing/ATX_PSU/mechanical/out/fan_down/gui_print_layout.png

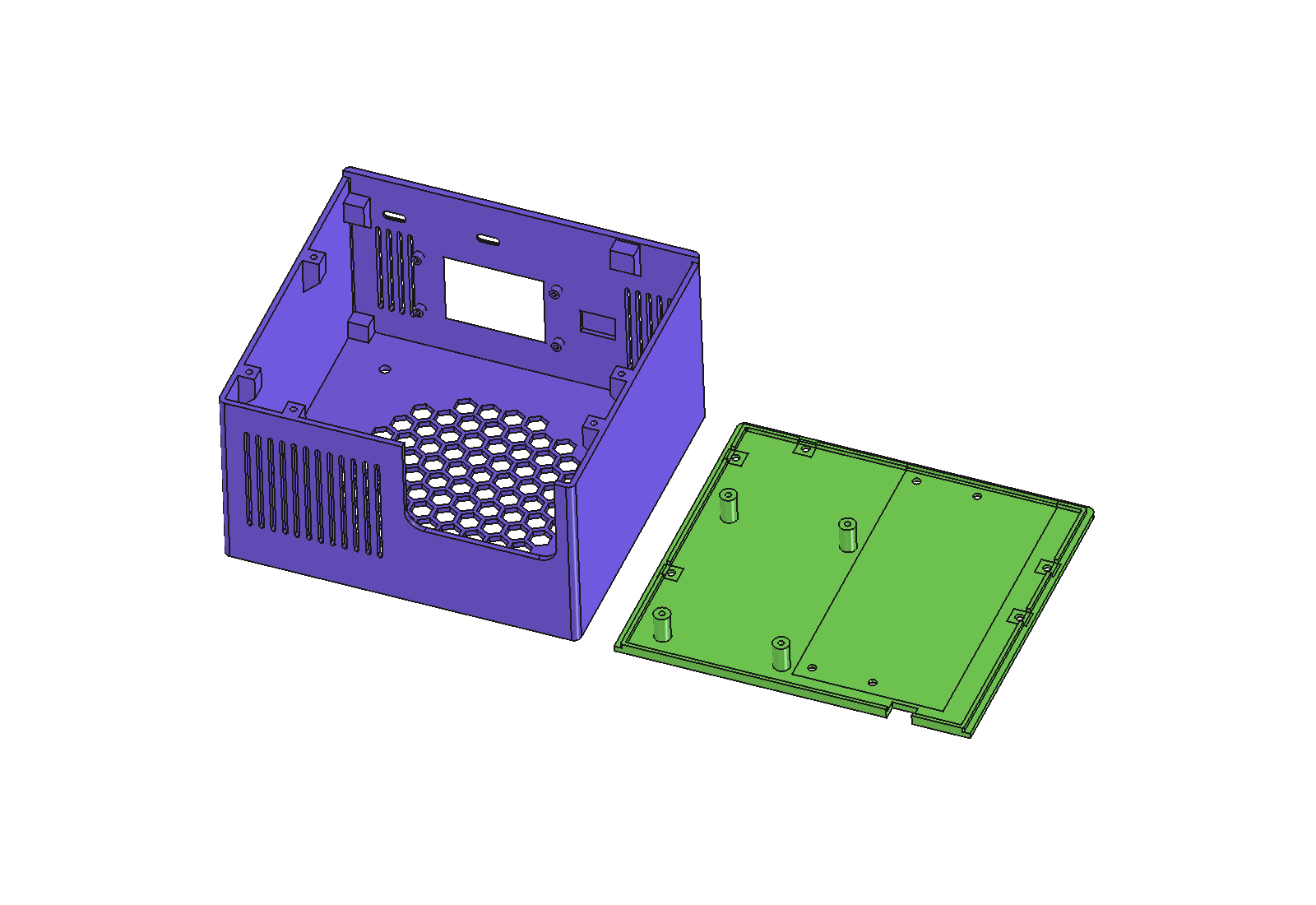
ATX_PSU/mechanical/out/fan_down/gui_print_layout.png
