RyuhungLiu/USB-PD-48V-ORing/Enclosure/out/gui_print_layout.png

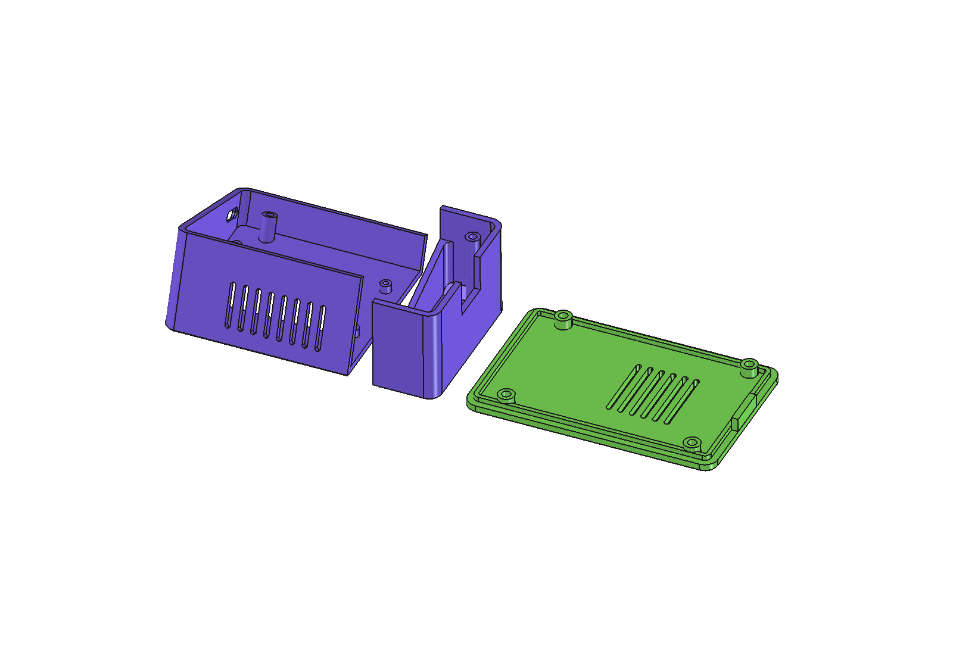
Enclosure/out/gui_print_layout.png
