RyuhungLiu/USB-PD-48V-ORing/MainCtrl/docs/step_0to5A_list.png

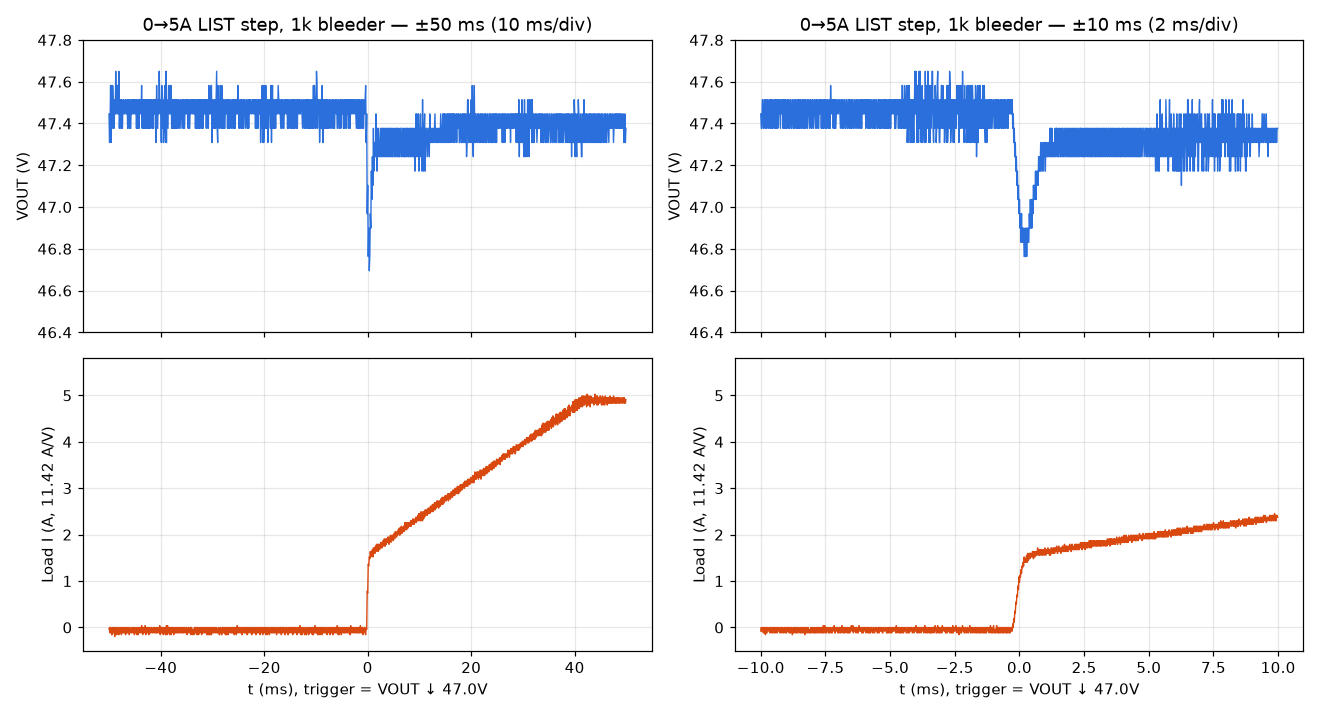
MainCtrl/docs/step_0to5A_list.png
