RyuhungLiu/USB-PD-48V-ORing/MainCtrl/docs/step_dyn_fast.png

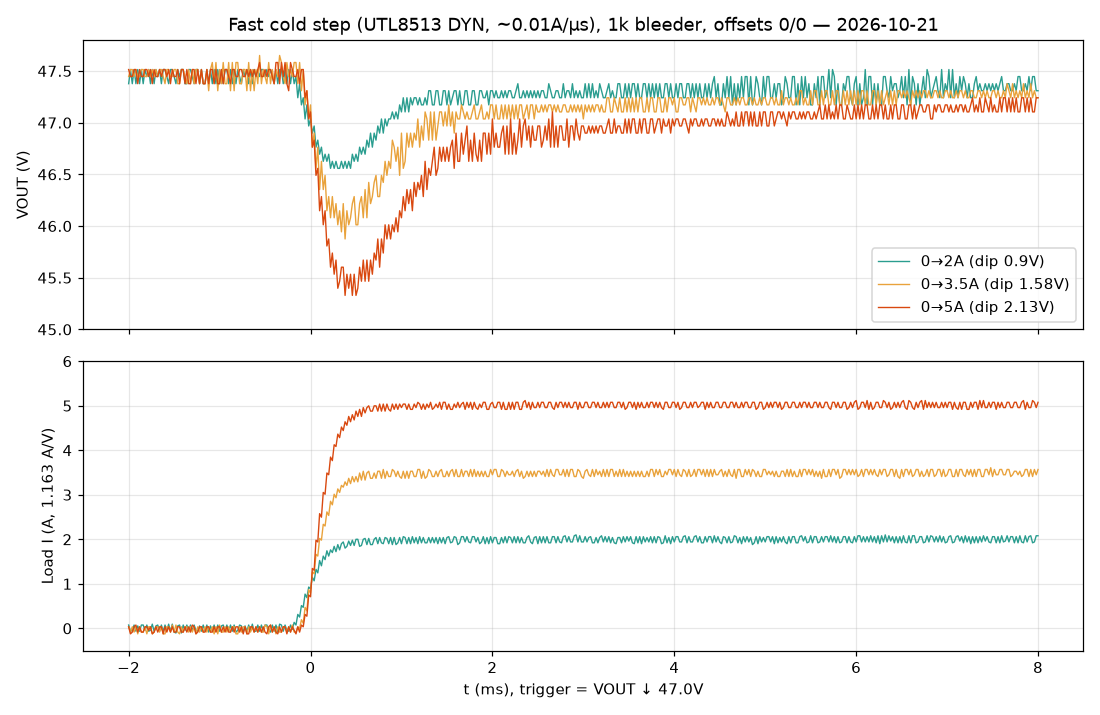
MainCtrl/docs/step_dyn_fast.png
