RyuhungLiu/USB-PD-48V-ORing/MainCtrl/docs/q3_failure_analysis.html

48V10+10A ORing · REV2 · CH1 · 2026-10-22

# Q3 Breakdown Analysis

The CH1 VIN-side MOSFET (Q3, IPT015N10N5) has failed with a D-S short for the second time. This page collects the evidence, uses a calibrated step model to recompute the stress of each type of event, compares it against the datasheet SOA, and evaluates the effect of switching to the IPT059N15N3ATMA1.

Controller U1 LTC4359 Q3/Q1 IPT015N10N5 ×2 (back-to-back) VOUT bleeder 1 kΩ Input protection SMCJ54A + 100 µF

Conclusion

## Answers to the two questions

Why did Q3 break down?

At turn-on it takes power beyond its SOA in the linear region. When VOUT is far below VIN, the LTC4359 charges the gate slowly with only 10 µA, and Q3 has to pass current across a 15–30 V drop for several ms.

- The worst case is a V203 warm restart: with the 1 kΩ bleeder added, VOUT has already discharged to about 2 V after 1.4 s off, and when the path is turned back on Q3 uses about 85–109 % of SOA in a single event. During flashing and watchdog resets the charger was observed being pulled down to 36 V three times.
- In the back-to-back arrangement only the VIN-side device must conduct "through its channel"; the VOUT-side device can conduct through its parasitic diode, so the failure is always on the VIN side (CH1 Q3 twice, CH2 VIN side once).
- The IPT015N10N5 (OptiMOS 5) has a very weak SOA in the 20–30 V range: 30 V / 10 ms allows only 2.1 A.

Does switching to the IPT059N15N3ATMA1 fix it for good?

It greatly reduces the risk, but it is not a root fix. The same warm-restart event drops from 109 % to 19 %, about 5x margin; the trigger mechanism (slow gate, no inrush control) is unchanged.

- SOA at 30 V: 52 A for 1 ms and 16 A for 10 ms, 6–8x the current part; gate charge 69 nC, about 2/5, so less time in the linear region; 150 V rating.
- Cost: on-resistance 5.1 mΩ, about 0.26 W for the two devices per channel at 5 A (current part 0.07 W).
- Combined with the immediate warm-restart recovery in v0.0.83 (VOUT dip < 0.25 V), the observed failure path is removed. A true root fix requires adding inrush control in the board revision.

Virtual layout

## CH1 power path

Component placement and connections reconstructed from the REV2 schematic netlist (ProPrj 2026-10-10); not to scale with the actual routing. Click a component to see its role and stress; switch scenarios to see the current path and where heat is generated.

Normal conduction Warm restart / cold-start inrush EN off After Q3 breakdown (current state)

Evidence

## Timeline of failures and stress events

Only events that were logged or measured are listed. Red dots are damage, yellow dots are confirmed inrush or overload, green dots are countermeasures.

10-21 morning

First CH1 Q3 breakdown. Both switches on; no-load drop 0.44 V, 0.74 V at 2 A, VOUT-side MOSFET heating up (conducting through its parasitic diode). User replaced Q3. Firmware v0.0.78 added OFF LEAK / PATH DROP.

10-21

CH2 VIN-side MOSFET damaged, replaced. Afterwards an SMCJ54A TVS and a 100 V 100 µF capacitor were added to each input.

10-21 afternoon

Cold-start step investigation. DYN falsely triggered a 0→6A cold step and both chargers dropped out at once; without a bleeder, 0→2A: VOUT fell by more than 22 V for over 5 ms.

10-21 evening

2 kΩ bleeder added on VOUT, later changed to 1 kΩ. Cold-step drop reduced to 1.02 V (0→4A). It also makes VOUT discharge with a 0.43 s time constant after turn-off, which made warm-restart inrush worse.

10-22 v0.0.82 flash

1.25 s after boot CH2 input 36.0 V (VOLTAGE shutdown), DETACH and reconnect 2.6 s later.

10-22 IWDG reset

1.42 s after boot CH1 input 36.08 V, charger DETACH and renegotiation.

10-22 v0.0.83 flash

1.49 s after boot CH1 input 35.76 V. This was the last restart using the old flow.

10-22 v0.0.83–84

Warm restart restores conduction immediately (turned on per the saved record within a few ms of boot). During verification there were 4 wlink resets, where the CPU was halted for about 0.4 s and VOUT dropped to about 19 V before the restart; with a firmware software reset the measured VOUT dip was < 0.25 V.

10-22 learning test

1→7A staircase and MANUAL comparison both normal; CH1 shared up to 3.3 A.

10-22 NORMAL test

After about 1 s at 2 A steady state VOUT 47.77 → 39.63 V, the whole board lost power and restarted (cause not fully determined, possibly the moment Q3 failed). On the rerun CH2 was already lowered by 500 mV but CH1 still only had 6 mA → PATH DROP latch; at 7A CH2 OCP XFER.

10-22 confirmation

With both EN off, CH1 still supplies 48 mA (bleeder current), VIN−VOUT = 0.55 V: Q3 D-S short, with current flowing through the Q1 parasitic diode.

Stress simulator

## How much SOA Q3 uses in each event

Model: LTC4359 gate charged by IGATE, piecewise gate charge and Miller capacitance of both MOSFETs, square-law channel, VOUT-side parasitic diode, 100 µF input capacitor, charger internal resistance 0.09 Ω with current limit, 435 µF output. Calibrated against oscilloscope measurements (2 kΩ bleeder 0→2A drop 2.79 V / no bleeder VOUT 25.3 V). Both MOSFETs are computed simultaneously.

Warm restart · 1k · off 1.4 s Warm restart · 2k wlink reset (halted 0.4 s) Cold start 0→2A, no bleeder Cold start 0→5A · 1k Cold start 0→7A · 1k

VOUT before event Steady state (cold-start step)

Load step

VOUT bleeder resistor

Charger current limit

LTC4359 IGATE(UP)

### VOUT

V, event starts at 0 ms

IPT015N10N5IPT059N15N3

### Q3 power dissipation

W, VDS × ID (VIN-side MOSFET channel)

IPT015N10N5IPT059N15N3

### SOA comparison

log-log; solid = trajectory, dashed = that device's SOA limit at the equivalent pulse width, dot = equivalent rectangular pulse

IPT015N10N5IPT059N15N3

The SOA is read from the image of datasheet Diagram 3 (Tc = 25 °C, single pulse), with an error of about ±10 %; when the actual case temperature is above 25 °C the allowed values are lower. The equivalent pulse takes the period where dissipation exceeds 10 % of the peak, using the average VDS and ID; the SOA limit is interpolated in log(pulse width) between the 100 µs / 1 ms / 10 ms / DC curves. The model is conservative for cold steps with a bleeder resistor (1k 0→5A measured drop 2.13 V, model about 4.5 V).

Per scenario

## Preset scenario summary

Charger current limit 10 A, IGATE 10 µA. Utilization = equivalent pulse current ÷ SOA-allowed current at that pulse width.

Scenario | IPT015N10N5 | Equivalent pulse (015) | IPT059N15N3 | Equivalent pulse (059) | Actually occurred
Warm restart · 1k bleeder · off 1.4 s | 109 % | 2.6 ms · 27 V · 6.6 A | 19 % | 0.9 ms · 30 V · 10.1 A | v0.0.81–83 flashing, IWDG reset; charger pulled to 36 V three times
Warm restart · 1k · charger 6 A limit | 85 % | 2.8 ms · 25 V · 5.7 A | 14 % | 0.9 ms · 30 V · 7.9 A | Same as above (charger with a lower current limit)
Warm restart · 2k bleeder | 64 % | 2.4 ms · 22 V · 6.0 A | 14 % | 0.9 ms · 25 V · 9.6 A | Flashing during the 2k period on the evening of 10-21
wlink reset · 1k · halted 0.4 s | 29 % | 2.1 ms · 17 V · 5.2 A | 9 % | 0.8 ms · 19 V · 8.8 A | 4 times during v0.0.83 verification
Cold start 0→2A · no bleeder | 36 % | 2.1 ms · 16 V · 6.8 A | 4 % | 0.7 ms · 10 V · 7.7 A | 10-21 cold-step investigation (multiple times)
Cold start 0→5A · 1k bleeder | 1 % | 0.9 ms · 3 V · 6.2 A | 2 % | 0.4 ms · 2 V · 6.0 A | 10-22 DYN fast step
Cold start 0→7A · 1k · single channel | 2 % | 0.9 ms · 3 V · 8.1 A | 2 % | 0.5 ms · 2 V · 7.1 A | 10-21: the failure was charger overload, not the MOSFET

Root cause

## Causes ranked

# | Cause | Evidence | Verdict

1 | Linear-mode turn-on into a discharged VOUT on warm restart | The 1k bleeder discharges VOUT to about 2 V within 1.4 s; the charger input was observed pulled to 36 V and DETACHing three times; the model gives 85–109 % SOA per event (25 °C). | Primary cause
2 | Slow gate drive, no inrush control | LTC4359 IGATE(UP) is only 6–14 µA; two IPT015 total 338 nC, about 34 ms from 0 to fully on. The LTC4359 is an ideal diode controller and does not limit inrush current. | Design root
3 | The VIN-side MOSFET alone takes the linear region | In the back-to-back arrangement Q1 can conduct through its parasitic diode while Q3 must use its channel; all three failures were on the VIN side (CH1 Q3 ×2, CH2 VIN side ×1). | Determines failure location
4 | Weak linear-region SOA of the IPT015N10N5 | OptiMOS 5 with low RDS(on) and high gfs (280 S); SOA slope about −2 (thermally unstable region). 30 V: 8.8 A for 1 ms, 2.1 A for 10 ms. | Amplifying factor
5 | Cumulative damage from repeated pulses | Many flashes, resets and cold-step tests during development; repeated pulses close to the SOA cause thermal fatigue of the die attach and bond wires, eventually failing in a moderate event (10-22 NORMAL at 2 A). | Contributing factor
6 | Overvoltage / avalanche | SMCJ54A already added; when Q3 is off VDS = VOUT − VIN ≤ about 48 V, well below 100 V. | Ruled out
7 | Gate overvoltage | D5 (12 V) clamps G-S; VGS max 20 V. | Ruled out
8 | Steady-state conduction loss | 5 A × 1.3 mΩ ≈ 33 mW. | Ruled out

Part selection

## IPT015N10N5 vs IPT059N15N3ATMA1

Both are TOLL (HSOF-8) packages with compatible pinouts; no board change is needed.

Item | IPT015N10N5 (current) | IPT059N15N3ATMA1 | Impact
VDS rating | 100 V | 150 V | More overvoltage margin
RDS(on) typ/max | 1.3/1.5 mΩ | 5.1/5.9 mΩ | At 5 A, two devices per channel: 0.07 W → 0.26 W
Qg (typ) | 169 nC | 69 nC | Gate charging time about 2/5, shorter linear region
Vth/plateau voltage | 3.0/4.4 V | 3.0/5.4 V | LTC4359 drives 10–12 V, sufficient
gfs | 280 S | 172 S | Lower gfs is more stable in the linear region
SOA 20 V · 1 ms/10 ms/DC | 20/4.9/1.3 A | 84/32/11.6 A | 4–9x
SOA 30 V · 1 ms/10 ms/DC | 8.8/2.1/0.57 A | 52/16/5.8 A | 6–10x
Warm restart · 1k (model) | 109 % | 19 % | About 5x margin per event

Assessment: The part change brings the main event that has actually occurred from "beyond SOA" back to "about 1/5 of SOA", and since v0.0.83 has already eliminated warm-restart inrush, in practice this is enough to prevent the same failure from happening again. The trigger mechanism is still there, though: whenever VOUT is pulled down significantly during operation (hot-plugging a large capacitive load, recovering from an output short, a charger hiccuping repeatedly), Q3 will still turn on in the linear region. A root fix requires limiting inrush current in the board revision.

Countermeasures

## Recommendations and verification checklist

### Repair (this time)

1. Replace Q3 with an IPT059N15N3ATMA1. Replace both devices of the same channel together (they share a gate, so Vth and Qg should match); replacing CH2 at the same time is also recommended.
2. A Q3 breakdown often takes G-S and G-D with it: check D5 (12 V Zener) and R15 (10 Ω), and measure whether U1 GATE is about 10 V above SRC when powered.
3. Unpowered measurement: D-S in diode mode about 0.5 V in one direction, OL in reverse; G-S tens of kΩ (R12 ∥ U1).
4. Powered verification: CH1 ON, CH2 OFF, 0.3 A; VGS should be 10–12 V and VIN − VOUT only a few tens of mV.

### Firmware and operation

1. Done v0.0.83 immediate recovery on warm restart; v0.0.84 uses a firmware reset instead of wlink reset; v0.0.85 VIN LOST 25 ms.
2. To do Keep latched faults across warm reset (this time PATH DROP was cleared by the IWDG reset and then automatically turned back on).
3. To do Low-threshold OFF LEAK: with both channels off and no load, trip at > 20 mA (this time it was only 48 mA, which the 150 mA threshold could not catch).
4. Keep cold-start steps ≤ 5 A; do not hot-plug large capacitive loads during operation (e.g. the input capacitors of an ATX power supply).
5. When debugging use v203ctl reset, not wlink reset.

### Board revision (root fix)

1. Add inrush control: limit dV/dt or current at turn-on, e.g. an ideal diode controller with load-switch gate drive and settable dV/dt (something like the TI LM74800-Q1; specs need to be verified), or a hot-swap controller (with SOA timer).
2. Or keep the LTC4359 and add a VOUT pre-charge path that brings VOUT close to VIN before turn-on.
3. Choose MOSFETs rated for linear-region operation (e.g. series designed specifically for hot-swap), whose SOA curves are flat in the 20–40 V range.

Data sources: oscilloscope (DHO814) and UTL8513 measurements, V203 event logs (prot_log, pd_evt_log, share_hist), Infineon IPT015N10N5 Rev 2.4 / IPT059N15N3 Rev 2.2 datasheets, ADI LTC4359 datasheet, REV2 schematic netlist. Model source: MainCtrl/tools/mosfet_step_sim.py (this page is a JS port with the input capacitance and charger current limit added).
