RyuhungLiu/USB-PD-48V-ORing/MainCtrl/src/ui/pages/page_home.h

#pragma once

#include "ui/ui.h"

// Home page: the upper and lower bands are CH1 / CH2 power (no channel names, distinguished by position), the right side is total output power;
// when current sharing is on, sharing parameters are shown, with red / blue marking the higher / lower current channel. Short press enters the trend page, long press enters SETUP
extern const ui_page_t page_home;
