RyuhungLiu/USB-PD-48V-ORing/MainCtrl/src/ui/pages/page_setup.h

#pragma once

#include "ui/ui.h"

// Settings page (entered by long press from the diagnostics page): auto output on power-up, accumulated energy clear, parameter storage status
extern const ui_page_t page_setup;
