RyuhungLiu/USB-PD-48V-ORing/MainCtrl/src/ui/pages/page_trend.h

#pragma once

#include "ui/ui.h"

// Power trend page (entered by short press from the home page): CH1 / CH2 / total output power curves; long press toggles 30 seconds / 5 minutes, short press enters the MOS page
extern const ui_page_t page_trend;
